ssougu/6-DOF-ARM-PROJECT/analysis/figs/fig2_crossover.png

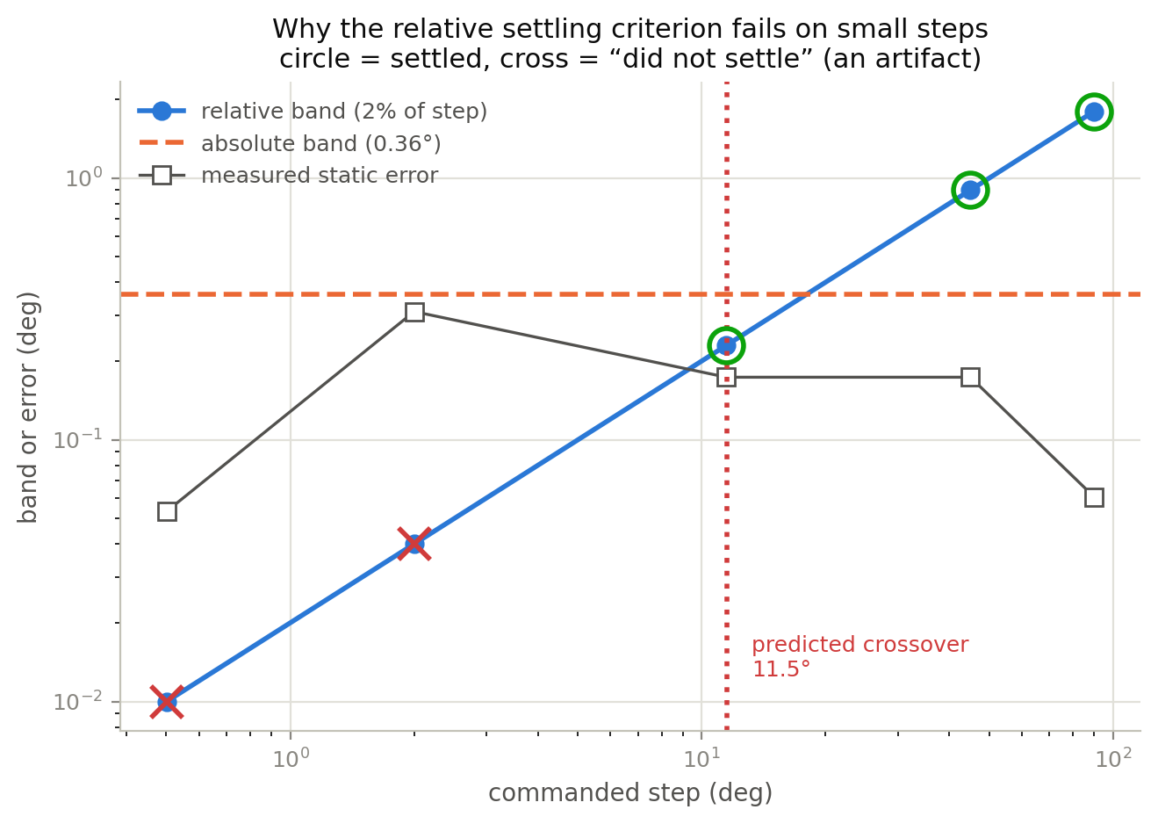
analysis/figs/fig2_crossover.png
