ssougu/6-DOF-ARM-PROJECT/analysis/figs/fig3_trajectory.png

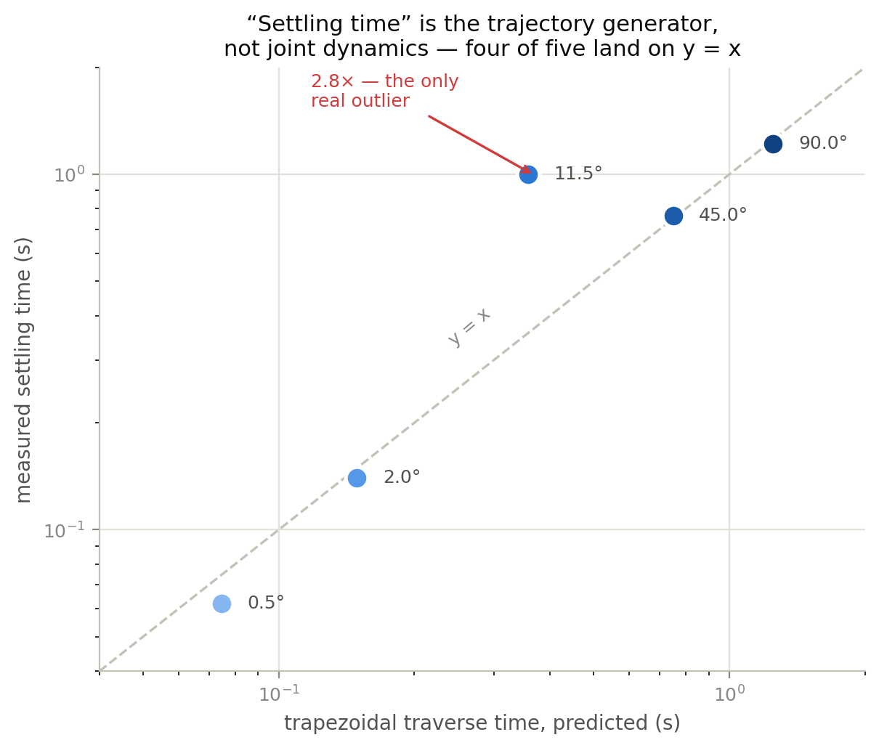
analysis/figs/fig3_trajectory.png
