ssougu/6-DOF-ARM-PROJECT/analysis/figs/fig4_jitter.png

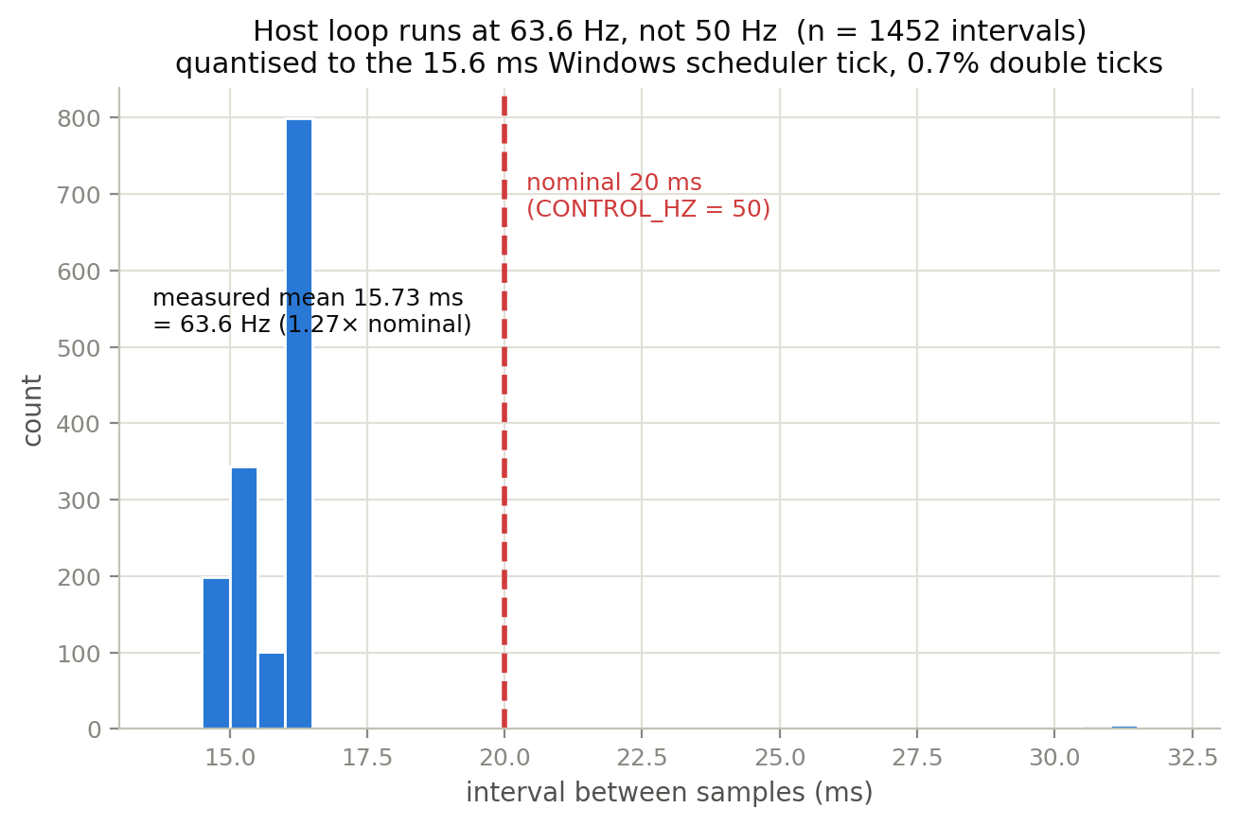
analysis/figs/fig4_jitter.png
