ssougu/6-DOF-ARM-PROJECT/analysis/figs/fig5_gain_sweep.png

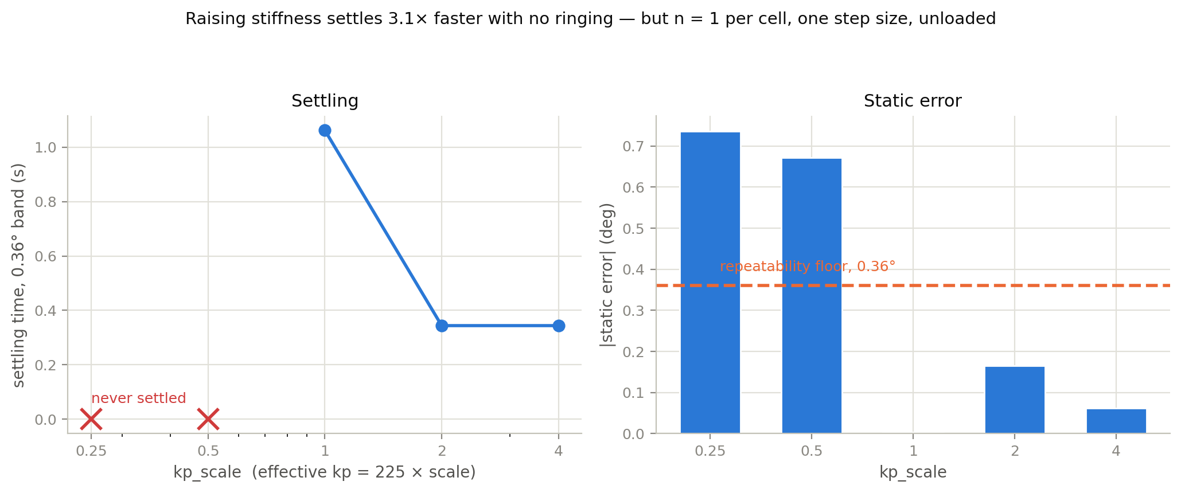
analysis/figs/fig5_gain_sweep.png
