ssougu/6-DOF-ARM-PROJECT/analysis/figs/fig6_torque.png

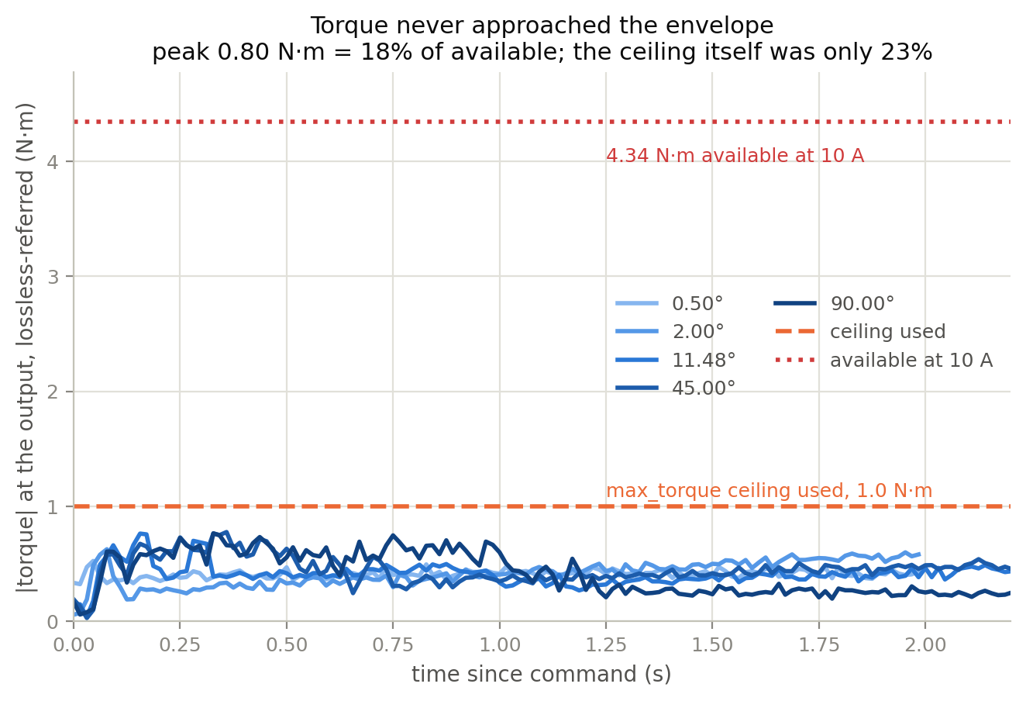
analysis/figs/fig6_torque.png
