ssougu/6-DOF-ARM-PROJECT/analysis/figs/fig7_repeatability.png

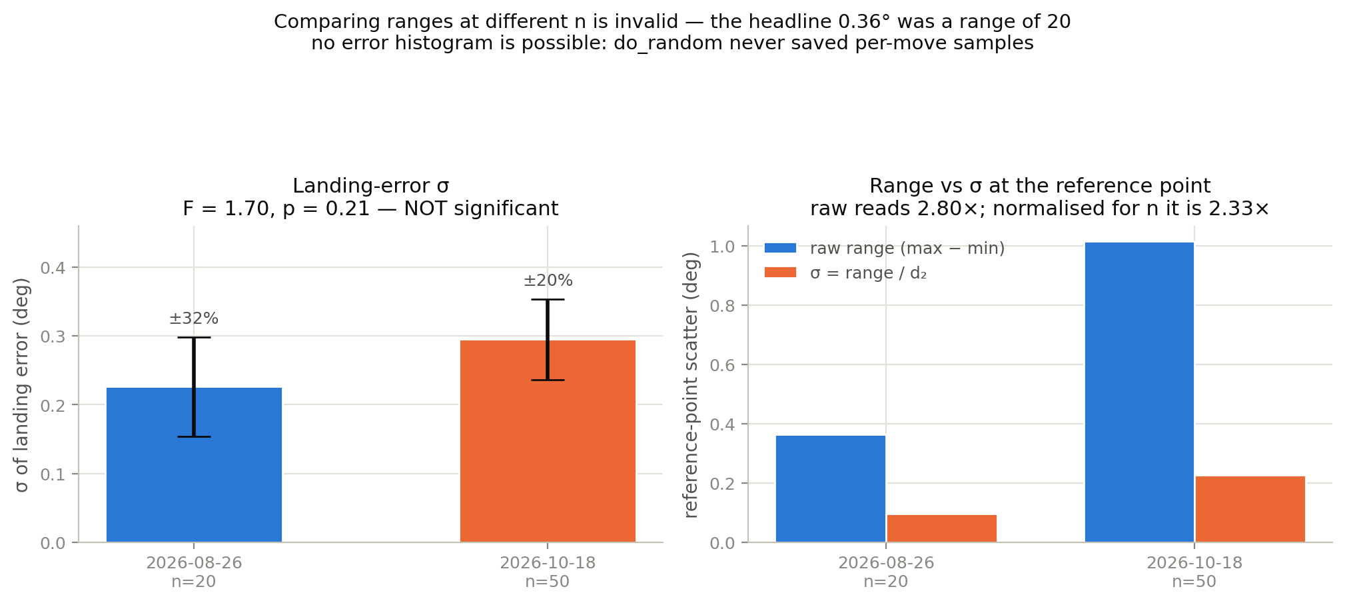
analysis/figs/fig7_repeatability.png
