ssougu/6-DOF-ARM-PROJECT/analysis/figs/fig8_capability.png

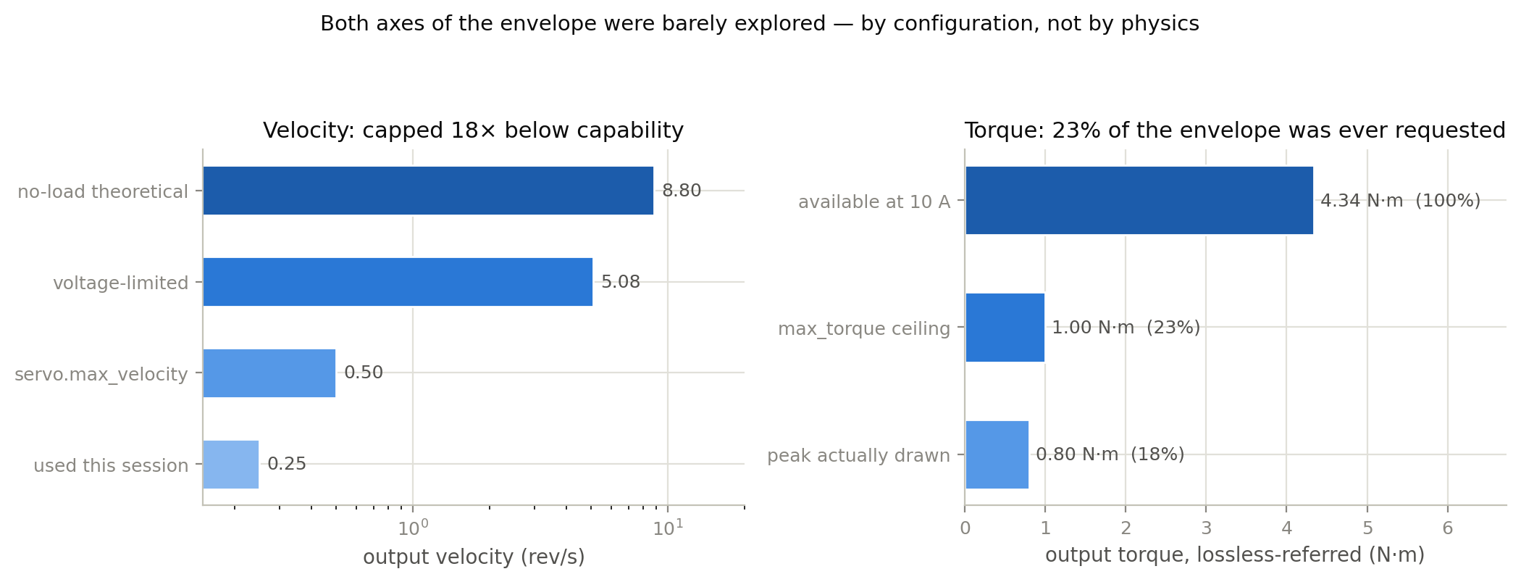
analysis/figs/fig8_capability.png
