ssougu/6-DOF-ARM-PROJECT/vision/charuco_7x5_25mm.png

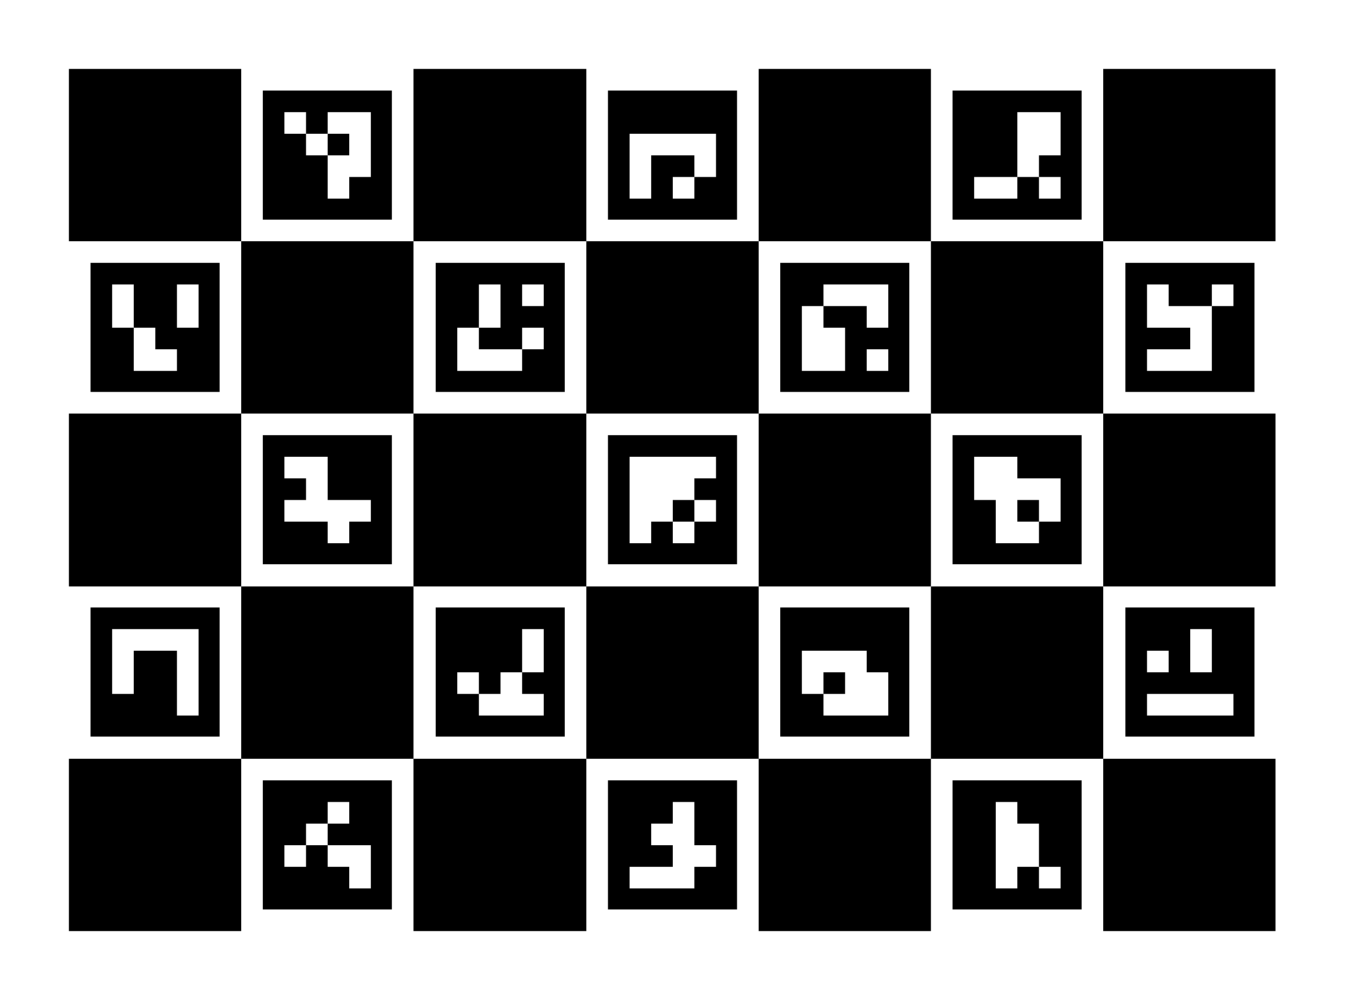
vision/charuco_7x5_25mm.png
