ssougu/6-DOF-ARM-PROJECT/analysis/figs/fig1_step_family.png

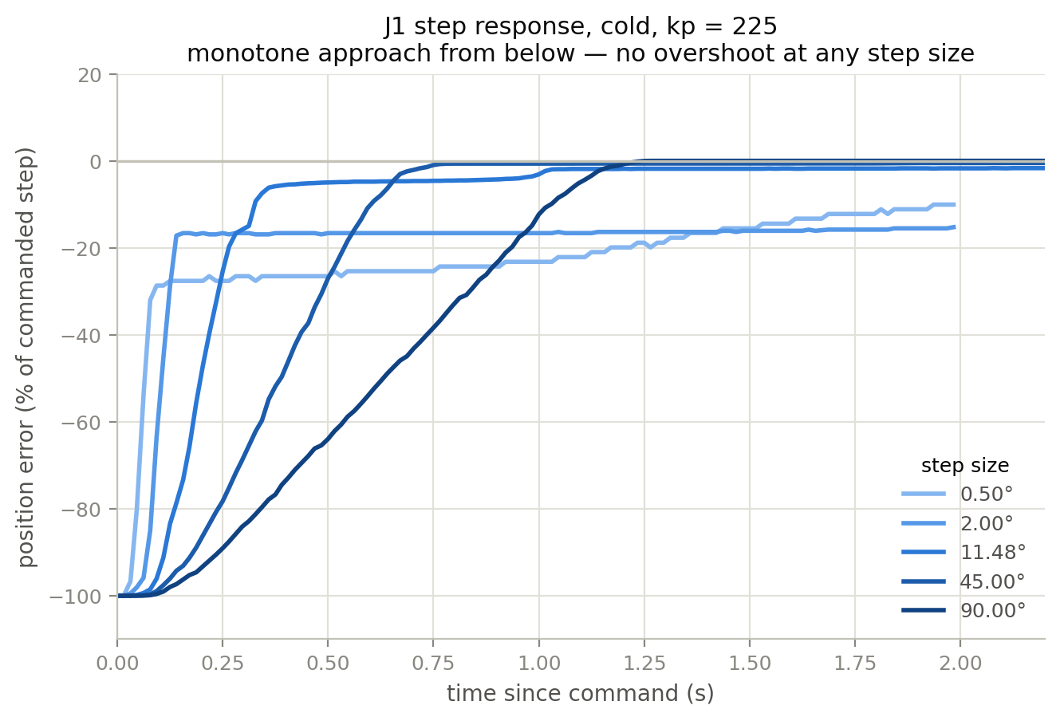
analysis/figs/fig1_step_family.png
