ssougu/6-DOF-ARM-PROJECT/(list of files, drawings)

Other design files:
hardware/arm-pdb/arm-pdb.PrjPcb
hardware/arm-pdb/arm-pdb/01-power-input.SchDoc
hardware/arm-pdb/arm-pdb/02-power-rails.SchDoc
hardware/arm-pdb/arm-pdb/03-mcu-can.SchDoc
hardware/arm-pdb/arm-pdb/4-steppers.SchDoc
hardware/arm-pdb/arm-pdb/05-servos.SchDoc
hardware/arm-pdb/arm-pdb/06-safety.SchDoc
hardware/arm-pdb/arm-pdb/arm-pdb.PrjPcb
hardware/arm-pdb/arm-pdb/PCB1.PcbDoc
