ssougu/6-DOF-ARM-PROJECT/(commit log)

2026-09-01 Initial commit: 6-DOF arm control stack
    Host (Python, asyncio):
    - joints.py Joint abstraction over moteus / stepper / sim
    - arm.py Arm: time-synchronised multi-joint motion, runtime
    joint enable/disable, route player, run logging
    - arm_console.py interactive + scriptable console
    - arm_server.py WebSocket control server (backend for the GUI)
    - sim_test.py, test_arm_server.py no-hardware test suites
    - routines/ warmup, demo, pick_place, workout motion files
    - logs/ J1 characterisation data, 2026-08-26
    Firmware:
    - j2_stepper/ ESP32, moteus-like serial protocol, trapezoidal motion
    UI:
    - ui/ Tauri v2 + SvelteKit desktop contro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
    [j1_history.csv]
2026-09-01 Add .gitattributes for line-ending normalisation
    Keeps LF in the repo and native in working copies, so collaborators on
    different machines don't generate whole-file diffs. Marks CAD/image
    formats binary ahead of mechanical files landing in the repo.
2026-09-01 Add README
    Project overview, current joint status, measured J1 performance, quick
    start (sim needs no hardware), architecture, safety model, and an index
    of the design docs.
2026-09-01 Add parts list
    What to buy by tier, what is already owned, and what is still blocked on
    mechanical decisions. Flags the power supply gap (24V 5A brick is not
    enough for the full arm) and the CAN-FD transceiver trap.
2026-09-03 Live hardware control from the GUI; fix J2 degree scale
    First live motion driven from the desktop app: J2 connected on COM3,
    armed, zeroed and jogged. J1 was off the bench being greased, so its
    live path is still unexercised.
    SIM/LIVE at runtime
    - The mode badge is now a button. restart_server and server_status
    existed in the Rust shell but nothing ever called invoke, so
    ARM_UI_SIM at launch was the only way into LIVE. SIM->LIVE asks for
    confirmation; the SIM default is what stops a stray click energizing
    a motor, and a one-click toggle would give that back.
    - New `shutdown` command de-energizes and exits cleanly. Previously a
    mode switch hard-killed the server, and TerminateProce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
    [arm.py, arm_server.py, main.cpp, test_arm_server.py]
2026-09-03 Add vision/: YOLO11m on CUDA, ChArUco calibration, ray-plane localisation
    Starts the perception half of the demo, which needs no arm and was 100%
    unstarted. Everything here runs on a laptop with a camera and a printed
    board, so it is not blocked on J2's gearbox.
    board.py ChArUco board, defined once, printable at exact scale
    camera.py capture; pins focus/exposure and reports what the
    driver actually did rather than what it accepted
    calibrate.py intrinsics from board views, with a coverage score
    detect.py YOLO11m on CUDA -> boxes + ground point
    locate.py pixel -> table mm by ray-plane
    check_vision.py 8 checks, PASS/FAIL, no came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
2026-09-03 Fix near-black frames from camera lock; judge focus by sharpness
    lock() switched auto-exposure off without supplying an exposure value,
    so the driver fell back to its manual default -- usually a very short
    exposure, giving a near-black image that looks like broken hardware.
    It now lets auto converge on the scene, reads the value it chose, pins
    that, and then checks the resulting picture rather than trusting the
    property. If the driver ignores manual exposure (this laptop's webcam
    does -- several very different values give an identical picture, which
    is now detected and used to stop probing) it stays on auto instead of
    handing back a black frame.
    Locked.ok was also wrong in principle: it re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
2026-09-03 Board: measure across the row, and don't reprint over a small scale error
    The printed guidance said to measure one square and reprint if it was
    not 25 mm. Both halves were poor advice.
    Measuring one square puts the full caliper error on a 25 mm number;
    spanning all seven and dividing puts the same error on 175 mm. And a
    uniformly scaled print does not need reprinting at all -- the square
    size only has to match reality, so passing the measured value to
    --squares-mm is correct and faster. What is fatal is using the nominal
    number when it is wrong, since that error never shows up in the
    reprojection residual.
2026-09-03 detect: class filtering and ground-point stability measurement
    Adds --list-classes, --label and --stability, so the demo object can be
    chosen and characterised before a calibration board exists.
    --stability is perception repeatability in pixels: put a stationary
    object down and measure how far the detected ground point wanders. Same
    kind of number as J1's 0.36 deg, and it converts straight to mm once
    intrinsics exist -- so the perception half of the error budget is
    measurable with no board.
    Detection rate is reported separately from jitter because they are
    different failure modes: a box that is steady in the 60% of frames where
    it appears is not usable, and neither is one found every frame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
2026-09-03 Docs: document vision/ in the tools guide; log 2026-09-03
    TOOLS_USER_GUIDE.md gains a vision section -- operating summary, the
    bring-up order for calibration, and a list of the things that look fine
    and are not (a scaled print, low reprojection error with thin coverage,
    AUTOFOCUS returning -1, locking exposure without a value, intrinsics at
    the wrong resolution, box centre as the grasp point). Quick-reference
    rows added, and the intro no longer claims the repo is only host/.
    CLAUDE.md: --stability and --list-classes in the command block, and the
    vision/ layout note updated.
    PROGRESS.md: the webcam is fixed-focus (sharpness cv 0.6-2.9% over three
    runs), so it is safe to calibrate and the Re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
2026-09-03 Parts list: add the bench electronics layer
    The list had the Teensy in Tier 2 with nothing to actually build on --
    no breadboard, no passives, no interface parts, and no statement of what
    each resistor is for. Adds all of that, plus a single ~$140 basket for
    ordering the Teensy stage now (nothing in it is blocked on a mechanical
    decision, and PJRC lead times are long).
    Notes worth having written down:
    - Socket the Teensy. It is the priciest bench part, it is 3.3 V and not
    5 V tolerant, and the PCB plan already calls for a socketed carrier.
    - A breadboard is the wrong home for CAN-FD at 5 Mbps -- no controlled
    impedance and every stub reflects. Fine for steppers, servos, limit
    switche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
2026-09-09 Add POWER_DISTRIBUTION.md: 36 V rail decision and load bounds
    Design basis for the arm's power system, written before the hardware
    exists -- loads are bounded from specifications, with measurement filling
    a second column as each joint comes online.
    Every number is tagged by source. Values read off a sheet we hold are
    marked; values that must be verified before being designed against are
    flagged. Five open items are called out, the first of which (the mj5208
    continuous rating) is what decides whether a 600 W supply is adequate.
    Rail: 36 V single, derived rather than assumed. 48 V is ruled out by the
    moteus 10-44 V input; 24 V sits at the bottom of the CL57T range and
    halves stepper current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
2026-09-15 Power architecture from datasheets; retire POWER_DISTRIBUTION.md
    Replaces the 2026-09-08 estimate-based power doc with a sourced design:
    36 V bus, rail tree, regeneration handling, the combined PDB + Teensy
    board, stackup, pin map, power budget and a bring-up checklist. Device
    figures now come from named datasheets rather than assumption.
    POWER_DISTRIBUTION.md is deleted rather than kept alongside. It is
    superseded on every point it covered, and two power documents that
    disagree on supply sizing is exactly the silent-partial-success failure
    this repo keeps warning about. Its harness content -- wire gauge, star
    grounding, shield termination -- is folded into section 9; the rest did
    not survi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
2026-09-15 hardware/: Altium project under version control, binaries on LFS
    Sets up the repo section for the PDB + Teensy board specified in
    POWER_ARCHITECTURE.md.
    LFS from the start for .SchDoc/.PcbDoc/.SchLib/.PcbLib and mechanical
    CAD formats. These are binary compound files rewritten whole on every
    save, so plain git stores a full copy per commit and the repo grows by
    megabytes a day. Tracking them now avoids a history rewrite later, which
    is the only other way to fix it. Patterns verified against Altium's mixed
    casing with git check-attr rather than assumed.
    .gitignore covers Altium's generated artifacts, History/ in particular --
    it keeps a copy of every save and reaches gigabytes on an active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
2026-09-15 Create arm-pdb Altium project skeleton
    [arm-pdb.PrjPcb]
2026-09-15 Flatten arm-pdb project folder
    [arm-pdb.PrjPcb]
2026-10-18 J1: first characterization session, plan, figures, and eight corrections
    Ran the Tier-0 (rotor-encoder-only) subset of a new J1 characterization plan
    on real hardware: 5 step responses across step size, a kp sweep, an n=50
    repeatability run, and a speed ladder. 15 records in host/logs/.
    Headline: the design figure is 0.685 deg -> 4.78 mm at 400 mm, 1.9x worse
    than the 0.36 deg previously used -- because 0.36 deg was never a sigma, it
    was the RANGE of 20 samples. Ranges grow with n, so it was never comparable
    to the 0.84 deg range-of-6 it was being compared against.
    Method findings, which matter more than the numbers:
    - goto/step are NOT step inputs. They pass through moteus's trajectory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
2026-10-20 host: fix ten silent-wrong-data defects found in a correctness audit
    Every one of these lets a wrong number look like a right one -- the failure
    mode this project already names as dominant. Found by auditing the code
    behind the 2026-10-18 measurements.
    The two serious ones:
    - MoteusJoint._run() swallows every exception by design, and _last carried no
    timestamp. So a dead CAN link left read() serving a frozen position with
    moving=False and fault=0 -- which Arm.move() reads as "arrived". _last is
    now stamped and aged out to fault=-1 after 3 stream periods, recovering
    when the link returns.
    - The settle tolerance was 2e-3 rev = 0.72 deg, BELOW the joint's own
    measured |mu|+2sigma l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
2026-10-20 arm: catch negative fault codes so a dead link cannot report "arrived"
    60aab2a added a staleness stamp so read() returns fault=-1 once telemetry
    ages out, but Arm.move()'s check was `fault > 0`, which a negative code
    skips. The same stale state carries moving=False, so the settle loop broke
    on its first pass and the move returned as ARRIVED in ~30 ms with a NaN
    position -- bypassing the settle-timeout raise that the same commit added.
    Net effect: pulling the fdcanusb mid-move reported success faster than
    before the fix, because the pre-fix frozen _last at least kept moving=True
    and ran to the deadline. Testing the two halves separately missed it:
    test_joints.py covers read() but never const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
2026-10-20 Add arm-pdb schematics, 2026-10-20 route logs, superseded J1 plan
    hardware/arm-pdb/arm-pdb/: six schematic sheets, the PCB and the project
    file, routed through LFS per .gitattributes. Altium's History/ and
    __Previews/ stay ignored. Note this sits one level below the already-tracked
    hardware/arm-pdb/arm-pdb.PrjPcb left by the earlier flatten -- the nested
    copy is the one carrying the design work. Which location is canonical is a
    decision for whoever opens it in Altium; not reorganised here.
    docs/J1_GEARBOX_CHARACTERIZATION_PLAN.md: written in parallel with
    J1_CHARACTERIZATION_PLAN.md and superseded by it. Banner at the top records
    the 15x torque error it originally contained (it asserted TOR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
